samuelboiss/SMeteo/README.md

# SMeteo
Bienvenue sur notre github !

Projet de KULBICKI Maximilien et BOIS Samuel.

Une station météo.
