samuelboiss/SMeteo/(commit log)

2021-11-27 Create SamuelBOIS.md
    Rapports de séances de BOIS Samuel G3
2021-11-27 Create MaximilienKULBICKI.md
    Rapports de séances de Maximilien KULBICKI G3
2021-11-27 Create Code Arduino
